Imre-Norbert/DC_Motor_Driver/DCMotorDriver_v2.0.pdf

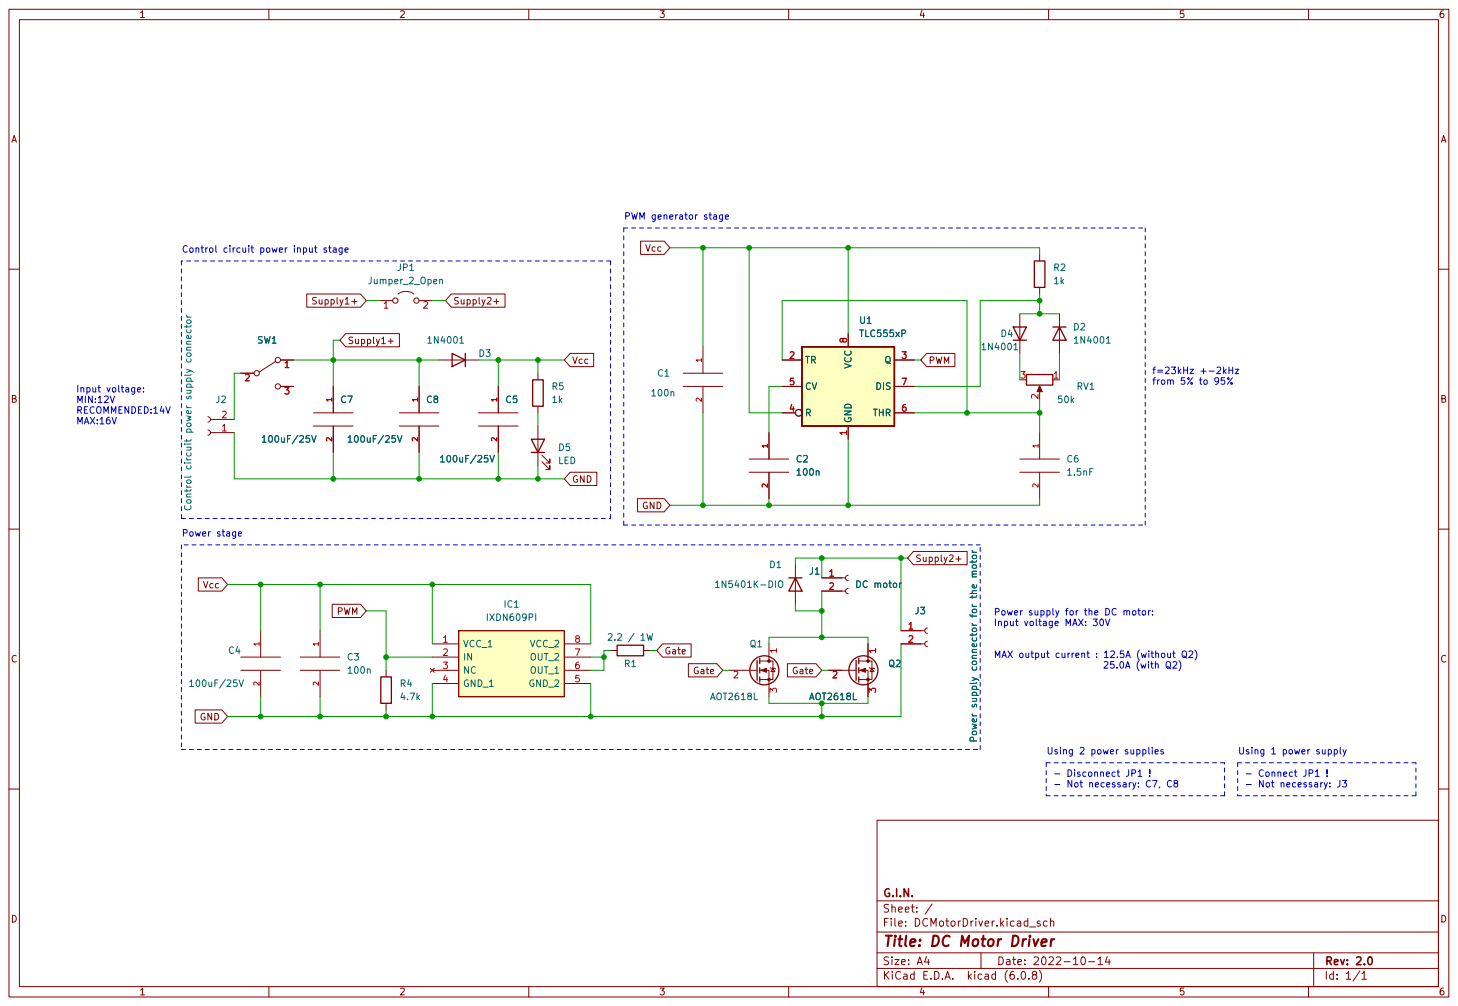
[picture p2: page 1]

Control circuit power input stage

Power supply for the DC motor:
Input voltage MAX: 30V

MAX output current : 12.5A (without Q2)

Id: 1/1 Title: DC Motor Driver
