Imre-Norbert/DC_Motor_Driver/KiCAD/DCMotorDriver/DCMotorDriver.pdf

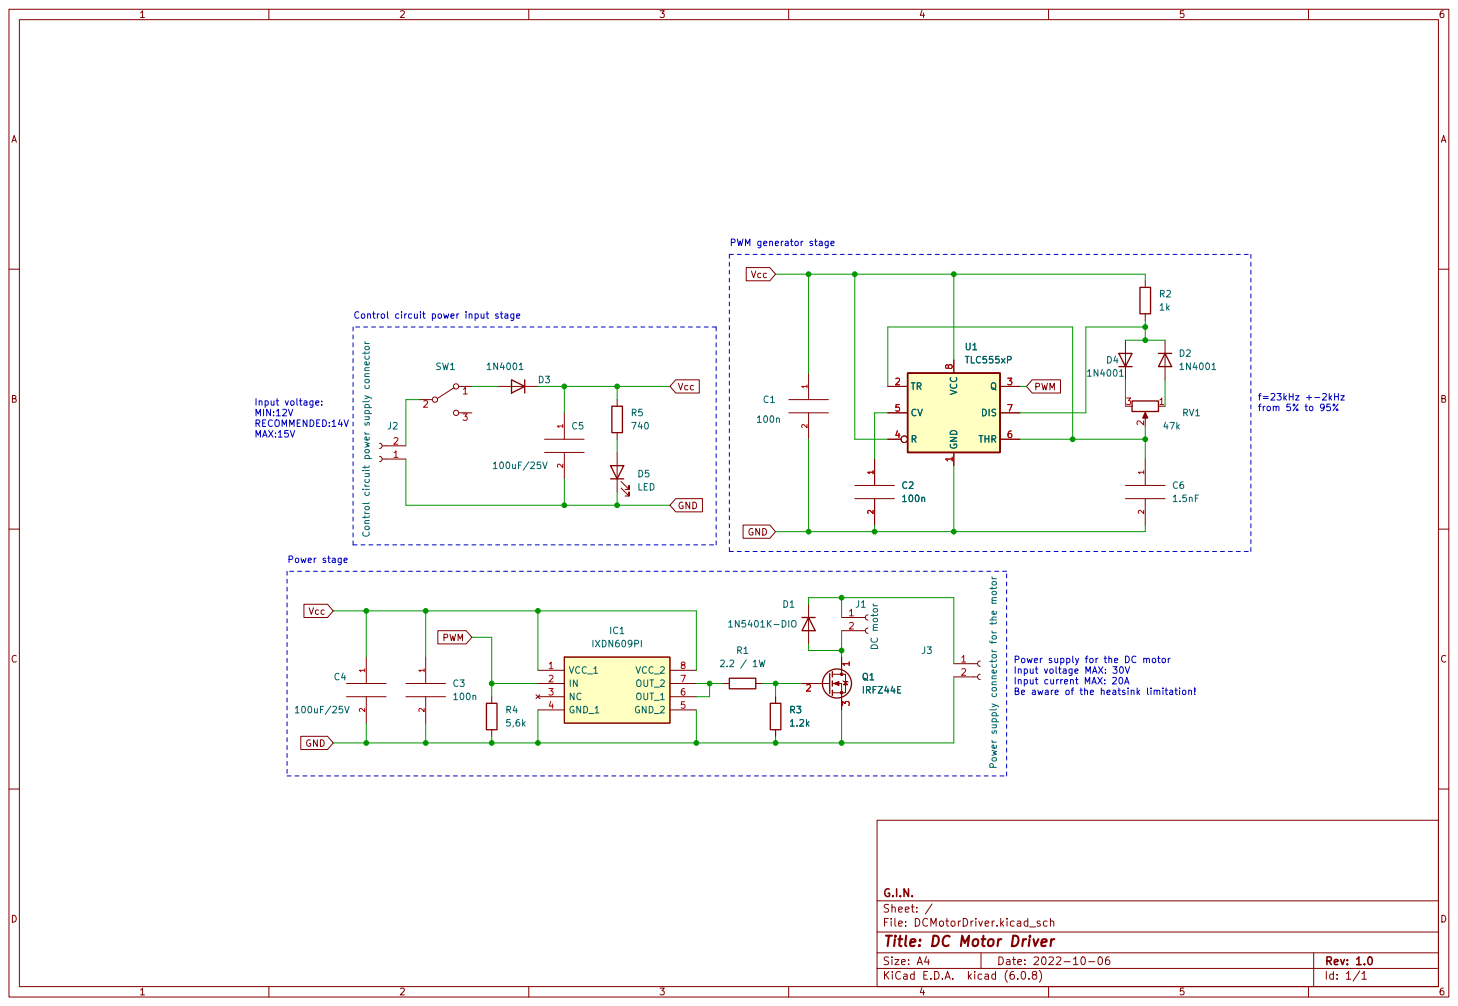
[picture p3: page 1]

Control circuit power input stage

Input voltage: MIN:12V RECOMMENDED:14V MAX:15V

Input voltage MAX: 30V
Input current MAX: 20A
Be aware of the heatsink limitation!

Id: 1/1 Title: DC Motor Driver
