Imre-Norbert/DC_Motor_Driver/DCMotorDriver_v3.0_Final.pdf

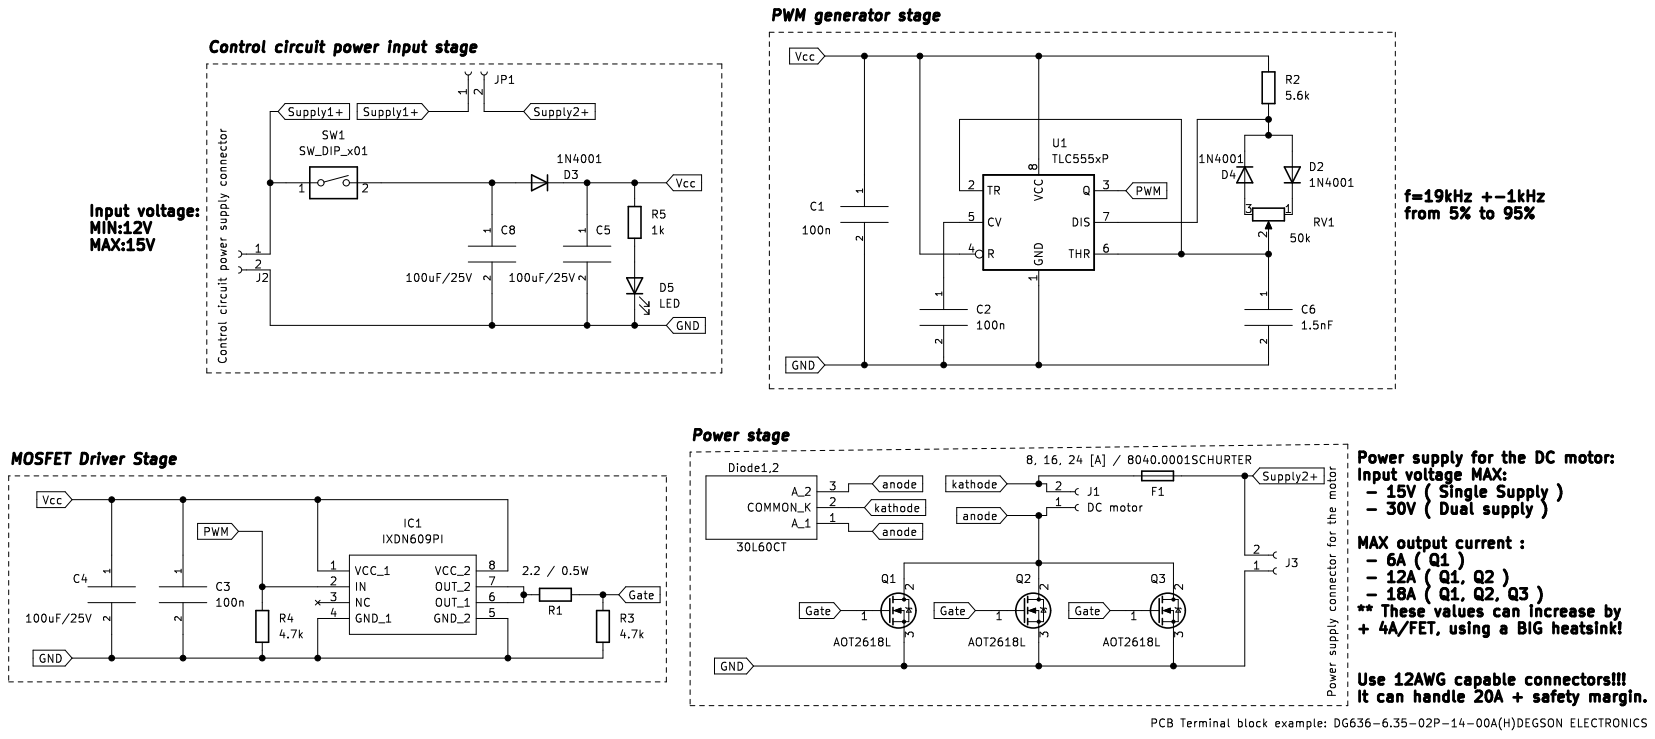
[picture p4: page 1]
