Imre-Norbert/DC_Motor_Driver/KiCAD/DCMotorDriver/DCMotorDriver.kicad_pcb

## KiCad design KiCAD/DCMotorDriver/DCMotorDriver.kicad_pcb (2022-12-04)

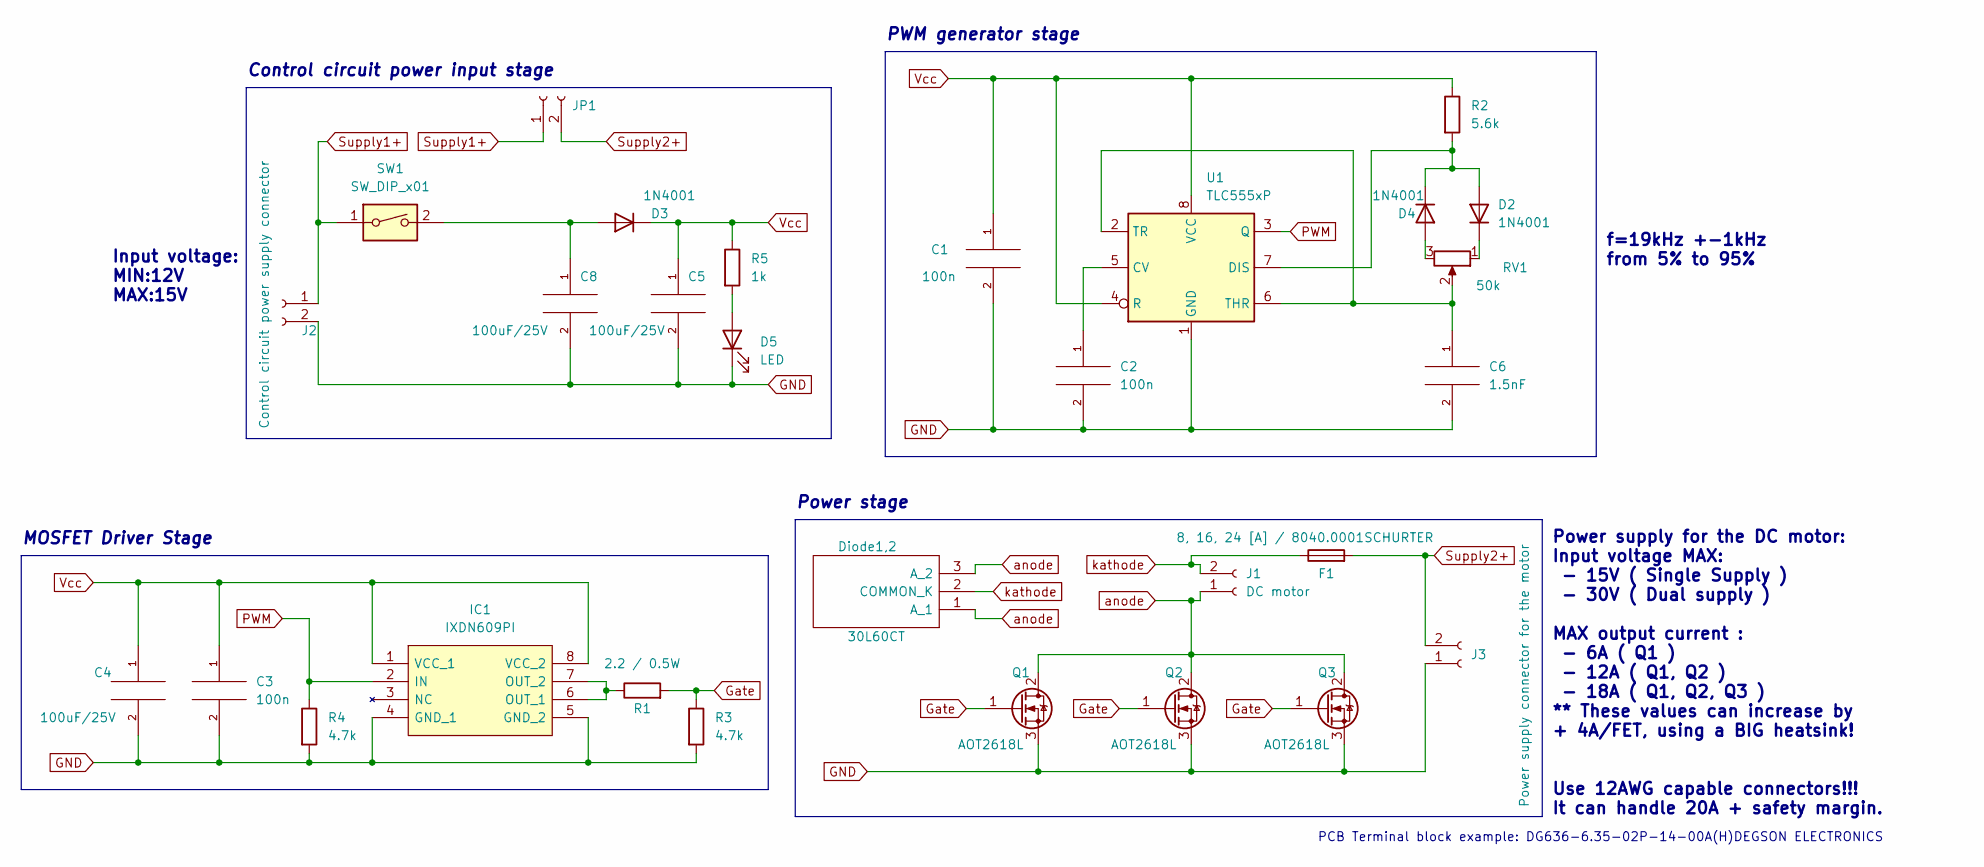
[picture p5: schematic DCMotorDriver.kicad_sch, DC Motor Driver]

Parts:
C1, C2, C3: 100n; C_Rect_L7.2mm_W2.5mm_P5.00mm_FKS2_FKP2_MKS2_MKP2
C4: 100uF/25V; C_Radial_D8.0mm_H11.5mm_P3.50mm
C5: 100uF/25V; C_Radial_D6.3mm_H11.0mm_P2.50mm
C6: 1.5nF; C_Rect_L7.2mm_W2.5mm_P5.00mm_FKS2_FKP2_MKS2_MKP2
C8: 100uF/25V; C_Radial_D12.5mm_H20.0mm_P5.00mm
D2, D3, D4: 1N4001; D_DO-41_SOD81_P10.16mm_Horizontal
D5: LED; LED_D5.0mm
Diode1,2: 30L60CT; TO-220-3_Vertical; Manufacturer_Part_Number MBRF10200CT; Mouser Part Number 576-MBRF10200CT
F1: 8, 16, 24 [A] / 8040.0001SCHURTER; Fuseholder_Clip-6.3x32mm_Littelfuse_102_122_Inline_P34.21x7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
IC1: IXDN609PI; DIP-8_W7.62mm; Manufacturer_Part_Number IXDN609PI; Mouser Part Number 849-IXDN609PI
J1: DC motor; JST_NV_B02P-NV_1x02_P5.00mm_Vertical
J2: Control circuit power supply connector; JST_NV_B02P-NV_1x02_P5.00mm_Vertical
J3: Power supply connector for the motor; JST_NV_B02P-NV_1x02_P5.00mm_Vertical
JP1: .; JST_NV_B02P-NV_1x02_P5.00mm_Vertical
Q1, Q2, Q3: AOT2618L; TO-220-3_Vertical
R1: 2.2 / 0.5W; R_Axial_DIN0207_L6.3mm_D2.5mm_P10.16mm_Horizontal
R2: 5.6k; R_Axial_DIN0204_L3.6mm_D1.6mm_P7.62mm_Horizontal
R3, R4: 4.7k; R_Axial_DIN0204_L3.6mm_D1.6mm_P7.62mm_Horizontal
R5: 1k; R_Axial_DIN0204_L3.6mm_D1.6mm_P7.62mm_Horizontal
RV1: 50k; Potentiometer_Piher_T-16H_Single_Horizontal
SW1: SW_DIP_x01; JST_NV_B02P-NV_1x02_P5.00mm_Vertical
U1: TLC555xP; DIP-8_W7.62mm

Connections:
GND: C1.2, C2.2, C3.2, C4.2, C5.2, C6.2, C8.2, D5.1 (K), IC1.4 (GND_1), IC1.5 (GND_2), J2.2, J3.1, Q1.3 (S), Q2.3 (S), Q3.3 (S), R3.2, R4.2, U1.1 (GND)
Gate: Q1.1 (G), Q2.1 (G), Q3.1 (G), R1.2, R3.1
unnamed: C2.1, U1.5 (CV)
unnamed: C6.1, RV1.2, U1.2 (TR), U1.6 (THR)
unnamed: C8.1, D3.2 (A), SW1.2
unnamed: D5.2 (A), R5.2
unnamed: IC1.6 (OUT_1), IC1.7 (OUT_2), R1.1
unnamed: D2.2 (A), D4.1 (K), R2.2, U1.7 (DIS)
unnamed: D2.1 (K), RV1.1
unnamed: D4.2 (A), RV1.3
PWM: IC1.2 (IN), R4.1, U1.3 (Q)
Supply1+: J2.1, JP1.1, SW1.1
Supply2+: F1.2, J3.2, JP1.2
Vcc: C1.1, C3.1, C4.1, C5.1, D3.1 (K), IC1.1 (VCC_1), IC1.8 (VCC_2), R2.1, R5.1, U1.4 (R), U1.8 (VCC)
anode: Diode1,2.1 (A_1), Diode1,2.3 (A_2), J1.1 (Pin_2), Q1.2 (D), Q2.2 (D), Q3.2 (D)
kathode: Diode1,2.2 (COMMON_K), F1.1, J1.2 (Pin_1)

Notes on the sheet:
Input voltage: MIN:12V MAX:15V
PWM generator stage
Control circuit power input stage
Power supply for the DC motor: Input voltage MAX: - 15V ( Single Supply ) - 30V ( Dual supply ) MAX output current : - 6A ( Q1 ) - 12A ( Q1, Q2 ) - 18A ( Q1, Q2, Q3 ) ** These values can increase by + 4A/FET, using a BIG heatsink! Use 12AWG capable connectors!!! It can handle 20A + safety margin.
MOSFET Driver Stage
f=19kHz +-1kHz from 5% to 95%
Power stage
PCB Terminal block example: DG636-6.35-02P-14-00A(H)DEGSON ELECTRONICS

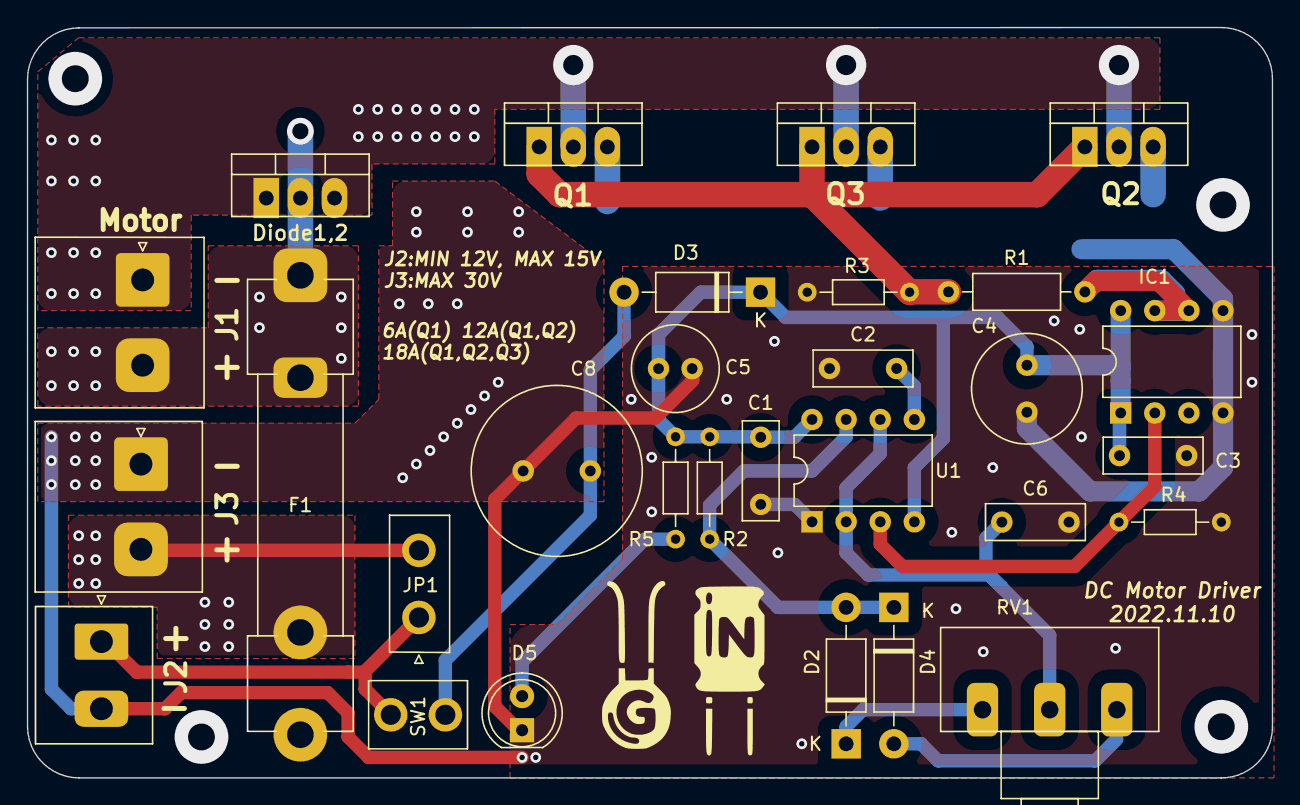
[picture p6: board DCMotorDriver.kicad_pcb from above]

Board: 2 copper layers, 92.7 x 55.9 mm, 29 parts (0 on the bottom side), 16 nets.
